timothyhollabaugh/micromouse/non_technical/flow.png

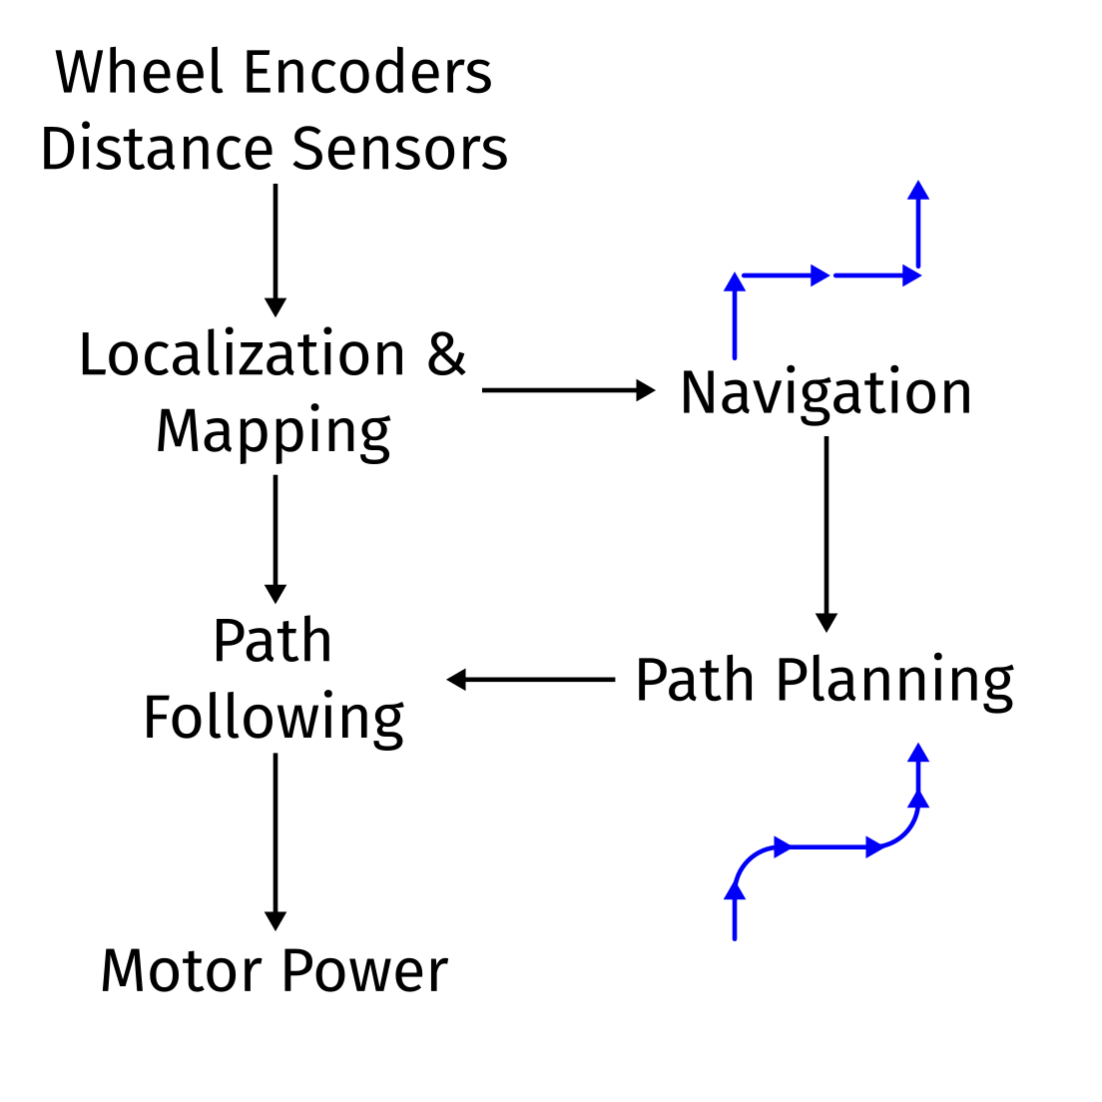
non_technical/flow.png
