timothyhollabaugh/micromouse/electrical/programmer/programmer-F_Cu.dxf

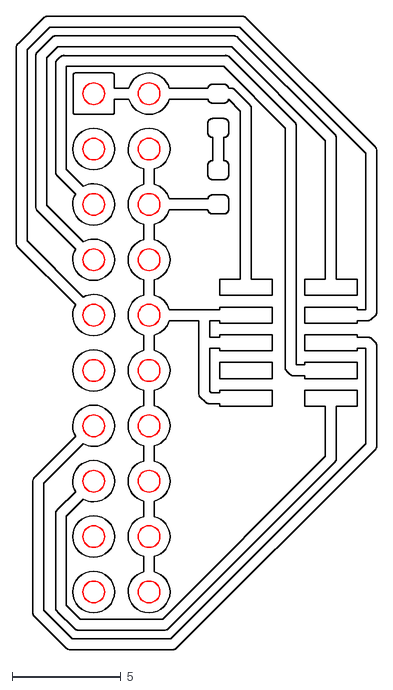
[picture p2: CAD file, 2020-02-29]
electrical/programmer/programmer-F_Cu.dxf
16.5 x 29.1
