timothyhollabaugh/micromouse/non_technical/paths.dxf

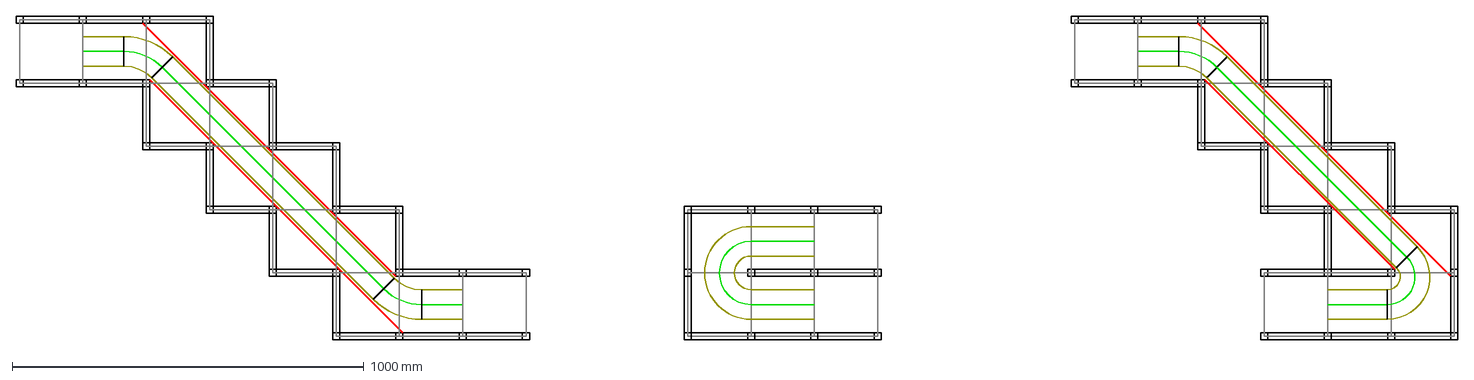
[picture p3: CAD file, 2020-01-07]
non_technical/paths.dxf
4100.0 x 920.0 mm
