timothyhollabaugh/micromouse/electrical/programmer/programmer-Edge_Cuts.dxf

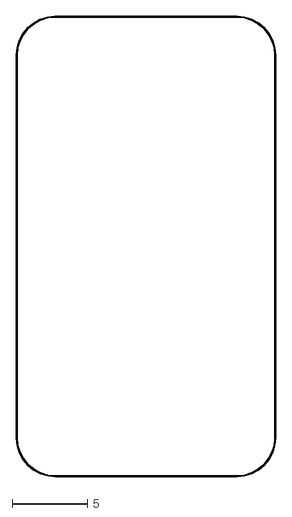
[picture p4: CAD file, 2020-02-29]
electrical/programmer/programmer-Edge_Cuts.dxf
17.2 x 30.5
