timothyhollabaugh/micromouse/electrical/programmer/programmer-B_Cu.dxf

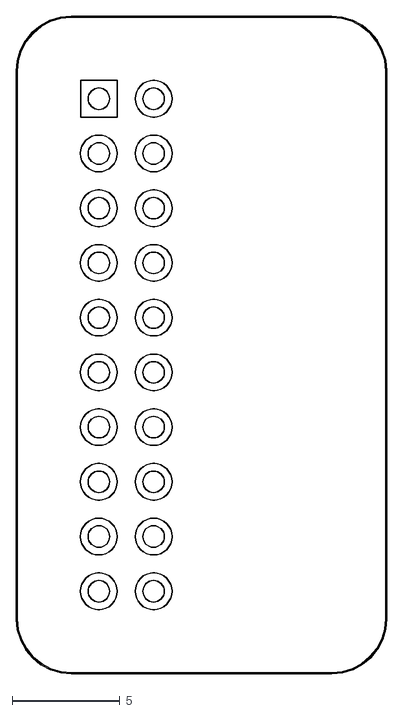
[picture p5: CAD file, 2020-02-29]
electrical/programmer/programmer-B_Cu.dxf
17.2 x 30.5
