timothyhollabaugh/micromouse/electrical/board/board2.kicad_pcb

## KiCad design electrical/board/board2.kicad_pcb (2020-02-29)

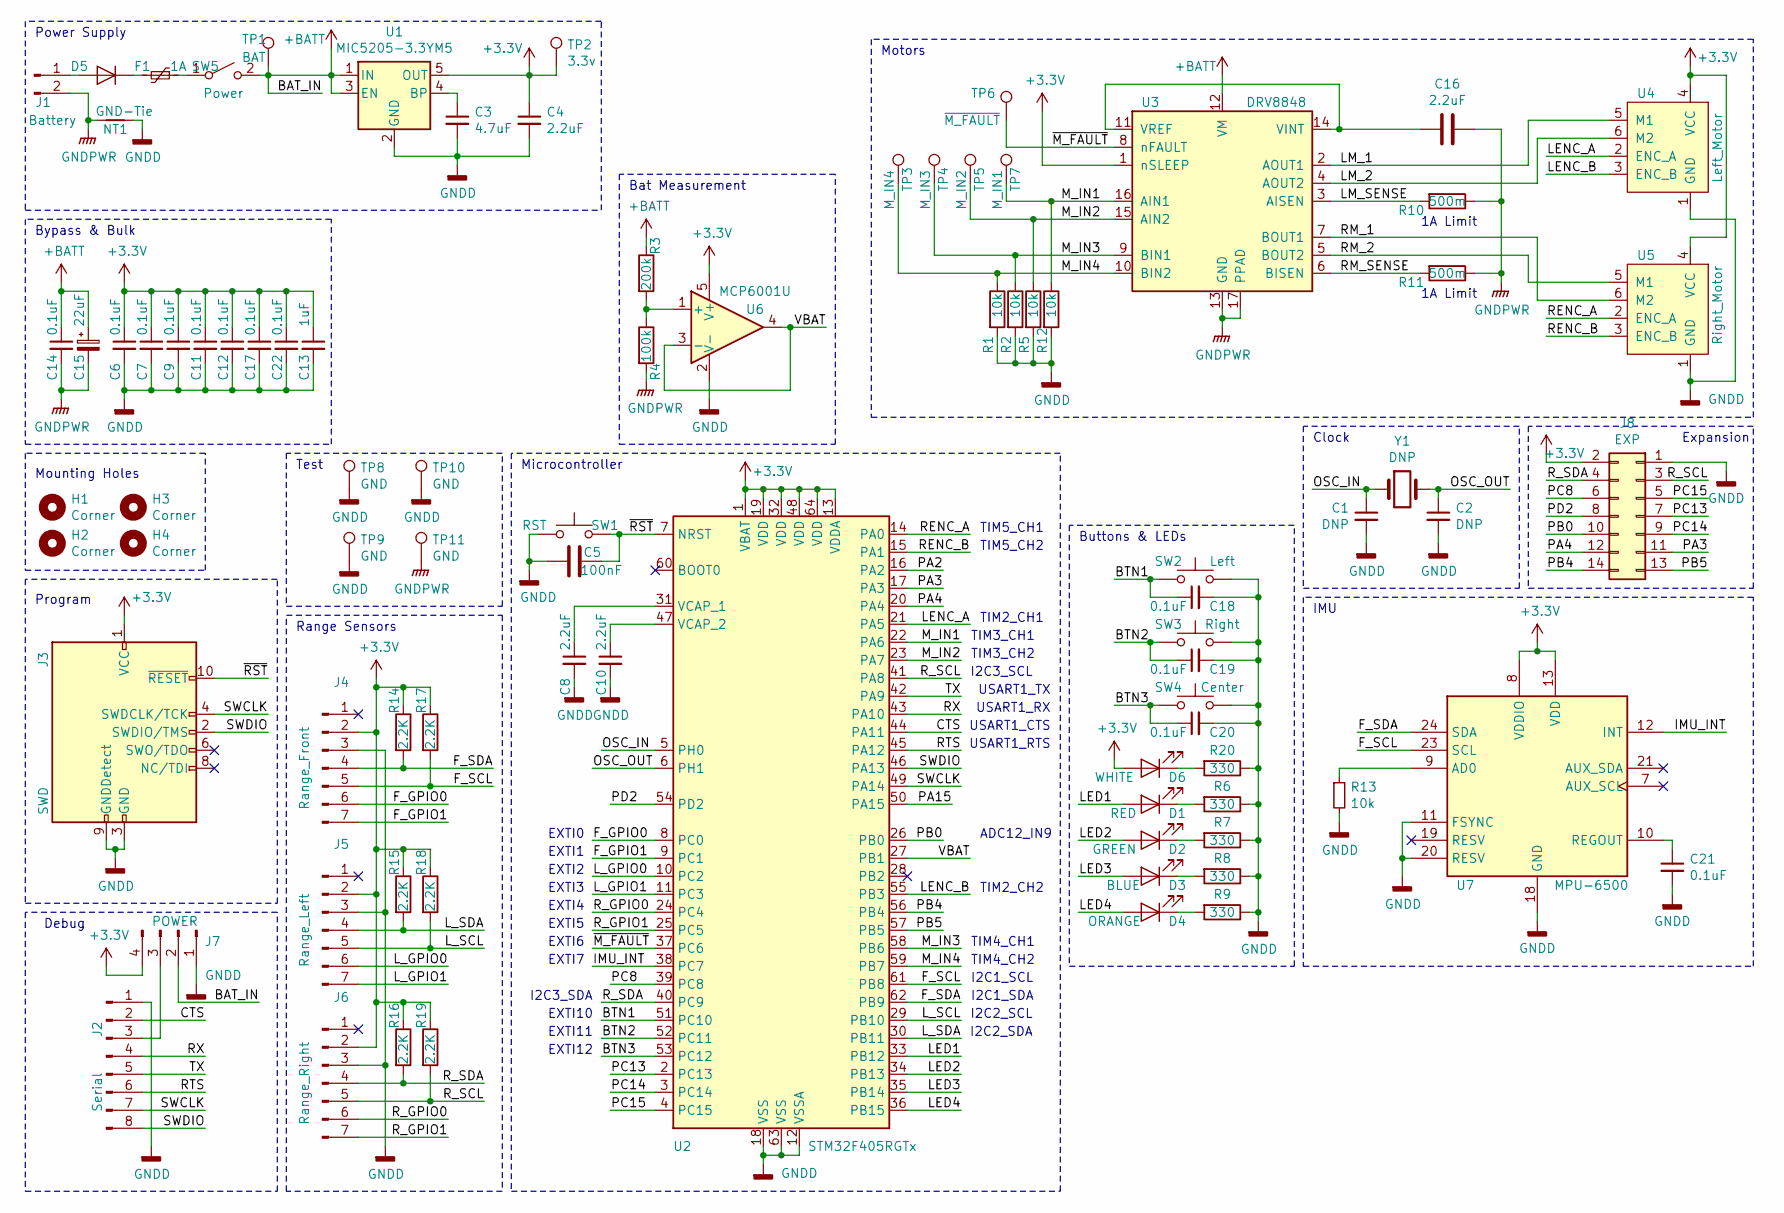
[picture p6: schematic board2.sch, Micromouse]

Parts:
C1, C2: DNP; C_0603_1608Metric
C3: 4.7uF; C_0603_1608Metric
C4, C8, C10, C16: 2.2uF; C_0603_1608Metric
C5: 100nF; C_0603_1608Metric
C6, C7, C9, C11, C12, C14, C17, C18, C19, C20, C21, C22: 0.1uF; C_0603_1608Metric
C13: 1uF; C_0603_1608Metric
C15: 22uF; CP_Elec_4x4.5
D1: RED; LED_0603_1608Metric
D2: GREEN; LED_0603_1608Metric
D3: BLUE; LED_0603_1608Metric
D4: ORANGE; LED_0603_1608Metric
D5: DB2441700L; SC-110A-2
D6: WHITE; LED_0603_1608Metric
F1: 1A; Littlefuse_154
H1, H2, H3, H4: Corner; MountingHole_2.2mm_M2
J1: Battery; PinHeader_1x02_P2.54mm_Horizontal
J2: Serial; PinHeader_1x08_P2.54mm_Vertical_SMD_Pin1Left
J3: SWD; PinHeader_2x05_P1.27mm_Vertical_SMD
J4: Range_Front; PinSocket_1x07_P2.54mm_Vertical
J5: Range_Left; PinSocket_1x07_P2.54mm_Vertical
J6: Range_Right; PinSocket_1x07_P2.54mm_Vertical
J7: POWER; PinHeader_1x04_P2.54mm_Vertical_SMD_Pin1Left
J8: EXP; PinHeader_2x07_P2.00mm_Vertical_SMD
NT1: GND-Tie; NetTie-2_SMD_Pad0.5mm
R1, R2, R5, R12, R13: 10k; R_0603_1608Metric
R3: 200k; R_0603_1608Metric
R4: 100k; R_0603_1608Metric
R6, R7, R8, R9, R20: 330; R_0603_1608Metric
R10, R11: 500m; R_1210_3225Metric
R14, R15, R16, R17, R18, R19: 2.2K; R_0603_1608Metric
SW1: RST; SW_SPST_PTS810
SW2: Left; SW_SPST_PTS810
SW3: Right; SW_SPST_PTS810
SW4: Center; SW_SPST_PTS810
SW5: Power; PinHeader_2x01_P2.54mm_Vertical_SMD
TP1: BAT; TestPoint_Pad_1.8x1.0mm
TP2: 3.3v; TestPoint_Pad_1.8x1.0mm
TP3: M_IN4; TestPoint_Pad_1.8x1.0mm
TP4: M_IN3; TestPoint_Pad_1.8x1.0mm
TP5: M_IN2; TestPoint_Pad_1.8x1.0mm
TP6: ~M_FAULT; TestPoint_Pad_1.8x1.0mm
TP7: M_IN1; TestPoint_Pad_1.8x1.0mm
TP8, TP9, TP10, TP11: GND; TestPoint_Pad_1.8x1.0mm
U1: MIC5205-3.3YM5; SOT-23-5
U2: STM32F405RGTx; LQFP-64_10x10mm_P0.5mm
U3: DRV8848; TSSOP-16_4.4x5mm_P0.65mm
U4: Left_Motor; Molex_PicoBlade_53261-0671_1x06-1MP_P1.25mm_Horizontal
U5: Right_Motor; Molex_PicoBlade_53261-0671_1x06-1MP_P1.25mm_Horizontal
U6: MCP6001U; SOT-23-5
U7: MPU-6500; InvenSense_QFN-24_4x4mm_P0.5mm
Y1: DNP; Crystal_SMD_0603-2Pin_6.0x3.5mm

Connections:
+3V3: C4.1, C6.1, C7.1, C9.1, C11.1, C12.1, C13.1, C17.1, C22.1, D6.2 (A), J3.1 (VCC), J4.2, J5.2, J6.2, J7.4, J8.2, R14.1, R15.1, R16.1, R17.1, R18.1, R19.1, TP2.1, U1.5 (OUT), U2.1 (VBAT), U2.13 (VDDA), U2.19 (VDD), U2.32 (VDD), U2.48 (VDD), U2.64 (VDD), U3.1 (nSLEEP), U4.4 (VCC), U5.4 (VCC), U6.5 (V+), U7.8 (VDDIO), U7.13 (VDD)
+BATT: C14.1, C15.1, J7.2, R3.1, SW5.2 (B), TP1.1, U1.1 (IN), U1.3 (EN), U3.12 (VM)
/BTN1: C18.1, SW2.1, U2.51 (PC10)
/BTN2: C19.1, SW3.1, U2.52 (PC11)
/BTN3: C20.1, SW4.1, U2.53 (PC12)
/CTS: J2.2, U2.44 (PA11)
/F_GPIO0: J4.6, U2.8 (PC0)
/F_GPIO1: J4.7, U2.9 (PC1)
/F_SCL: J4.5, R17.2, U2.61 (PB8), U7.23 (SCL)
/F_SDA: J4.4, R14.2, U2.62 (PB9), U7.24 (SDA)
/IMU_INT: U2.38 (PC7), U7.12 (INT)
/LED1: D1.2 (A), U2.33 (PB12)
/LED2: D2.2 (A), U2.34 (PB13)
/LED3: D3.2 (A), U2.35 (PB14)
/LED4: D4.2 (A), U2.36 (PB15)
/LENC_A: U2.21 (PA5), U4.2 (ENC_A)
/LENC_B: U2.55 (PB3), U4.3 (ENC_B)
/LM_1: U3.2 (AOUT1), U4.5 (M1)
/LM_2: U3.4 (AOUT2), U4.6 (M2)
/LM_SENSE: R10.2, U3.3 (AISEN)
/L_GPIO0: J5.6, U2.10 (PC2)
/L_GPIO1: J5.7, U2.11 (PC3)
/L_SCL: J5.5, R18.2, U2.29 (PB10)
/L_SDA: J5.4, R15.2, U2.30 (PB11)
/M_IN1: R12.1, TP7.1, U2.22 (PA6), U3.16 (AIN1)
/M_IN2: R5.1, TP5.1, U2.23 (PA7), U3.15 (AIN2)
/M_IN3: R2.1, TP4.1, U2.58 (PB6), U3.9 (BIN1)
/M_IN4: R1.1, TP3.1, U2.59 (PB7), U3.10 (BIN2)
/OSC_IN: C1.1, U2.5 (PH0), Y1.1
/OSC_OUT: C2.1, U2.6 (PH1), Y1.2
/PA3: J8.11, U2.17 (PA3)
/PA4: J8.12, U2.20 (PA4)
/PB0: J8.10, U2.26 (PB0)
/PB4: J8.14, U2.56 (PB4)
/PB5: J8.13, U2.57 (PB5)
/PC8: J8.6, U2.39 (PC8)
/PC13: J8.7, U2.2 (PC13)
/PC14: J8.9, U2.3 (PC14)
/PC15: J8.5, U2.4 (PC15)
/PD2: J8.8, U2.54 (PD2)
/RENC_A: U2.14 (PA0), U5.2 (ENC_A)
/RENC_B: U2.15 (PA1), U5.3 (ENC_B)
/RM_1: U3.7 (BOUT1), U5.6 (M2)
/RM_2: U3.5 (BOUT2), U5.5 (M1)
/RM_SENSE: R11.2, U3.6 (BISEN)
/RTS: J2.6, U2.45 (PA12)
/RX: J2.4, U2.43 (PA10)
/R_GPIO0: J6.6, U2.24 (PC4)
/R_GPIO1: J6.7, U2.25 (PC5)
/R_SCL: J6.5, J8.3, R19.2, U2.41 (PA8)
/R_SDA: J6.4, J8.4, R16.2, U2.40 (PC9)
/SWCLK: J2.7, J3.4 (SWDCLK/TCK), U2.49 (PA14)
/SWDIO: J2.8, J3.2 (SWDIO/TMS), U2.46 (PA13)
/TX: J2.5, U2.42 (PA9)
/VBAT: U2.27 (PB1), U6.3 (-), U6.4
/~M_FAULT: TP6.1, U2.37 (PC6), U3.8 (nFAULT)
/~RST: C5.1, J3.10 (~RESET~), SW1.2, U2.7 (NRST)
GNDD: C1.2, C2.2, C3.2, C4.2, C5.2, C6.2, C7.2, C8.2, C9.2, C10.2, C11.2, C12.2, C13.2, C17.2, C18.2, C19.2, C20.2, C21.2, C22.2, J2.1, J3.3 (GND), J3.5 (GND), J3.9 (GNDDetect), J4.3, J5.3, J6.3, J7.1, J8.1, NT1.2, R1.2, R2.2, R5.2, R6.1, R7.1, R8.1, R9.1, R12.2, R13.2, R20.1, SW1.1, SW2.2, SW3.2, SW4.2, TP8.1, TP9.1, TP10.1, U1.2 (GND), U2.12 (VSSA), U2.18 (VSS), U2.63 (VSS), U4.1 (GND), U5.1 (GND), U6.2 (V-), U7.11 (FSYNC), U7.18 (GND), U7.20 (RESV)
GNDPWR: C14.2, C15.2, C16.1, J1.2, NT1.1, R4.2, R10.1, R11.1, TP11.1, U3.13 (GND), U3.17 (PPAD)
unnamed: C3.1, U1.4 (BP)
unnamed: C8.1, U2.31 (VCAP_1)
unnamed: C10.1, U2.47 (VCAP_2)
unnamed: C16.2, U3.11 (VREF), U3.14 (VINT)
unnamed: C21.1, U7.10 (REGOUT)
unnamed: D1.1 (K), R6.2
unnamed: D2.1 (K), R7.2
unnamed: D3.1 (K), R8.2
unnamed: D4.1 (K), R9.2
unnamed: D5.1 (K), F1.2
unnamed: D5.2 (A), J1.1
unnamed: D6.1 (K), R20.2
unnamed: F1.1, SW5.1 (A)
unnamed: J2.3, J7.3
unnamed: R3.2, R4.1, U6.1 (+)
unnamed: R13.1, U7.9 (AD0)

Notes on the sheet:
TIM3_CH1
TIM3_CH2
TIM4_CH1
TIM4_CH2
TIM5_CH1
TIM5_CH2
TIM2_CH1
TIM2_CH2
I2C1_SCL
I2C1_SDA
I2C2_SCL
I2C2_SDA
I2C3_SCL
I2C3_SDA
EXTI0
EXTI1
EXTI2
EXTI3
EXTI4
EXTI5
EXTI6
USART1_TX
USART1_RX
USART1_CTS
USART1_RTS
EXTI10
EXTI11
EXTI12
ADC12_IN9
EXTI7
Range Sensors
IMU
Microcontroller
Buttons & LEDs
Expansion
Clock
Program
Debug
Test
Power Supply
Bypass & Bulk
Bat Measurement
Motors
1A Limit
Mounting Holes

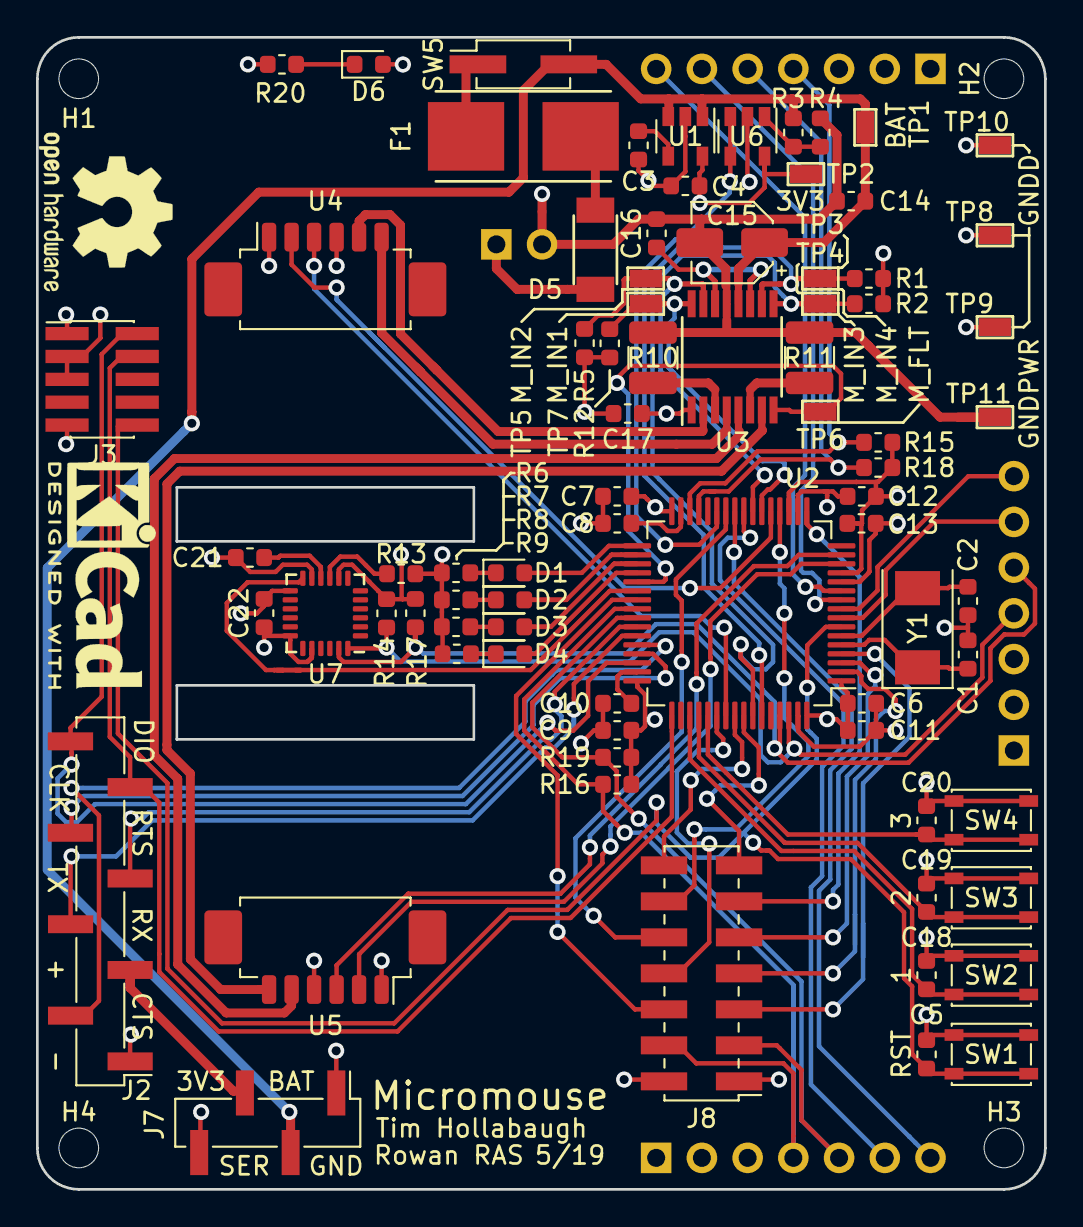
[picture p7: board board2.kicad_pcb from above]

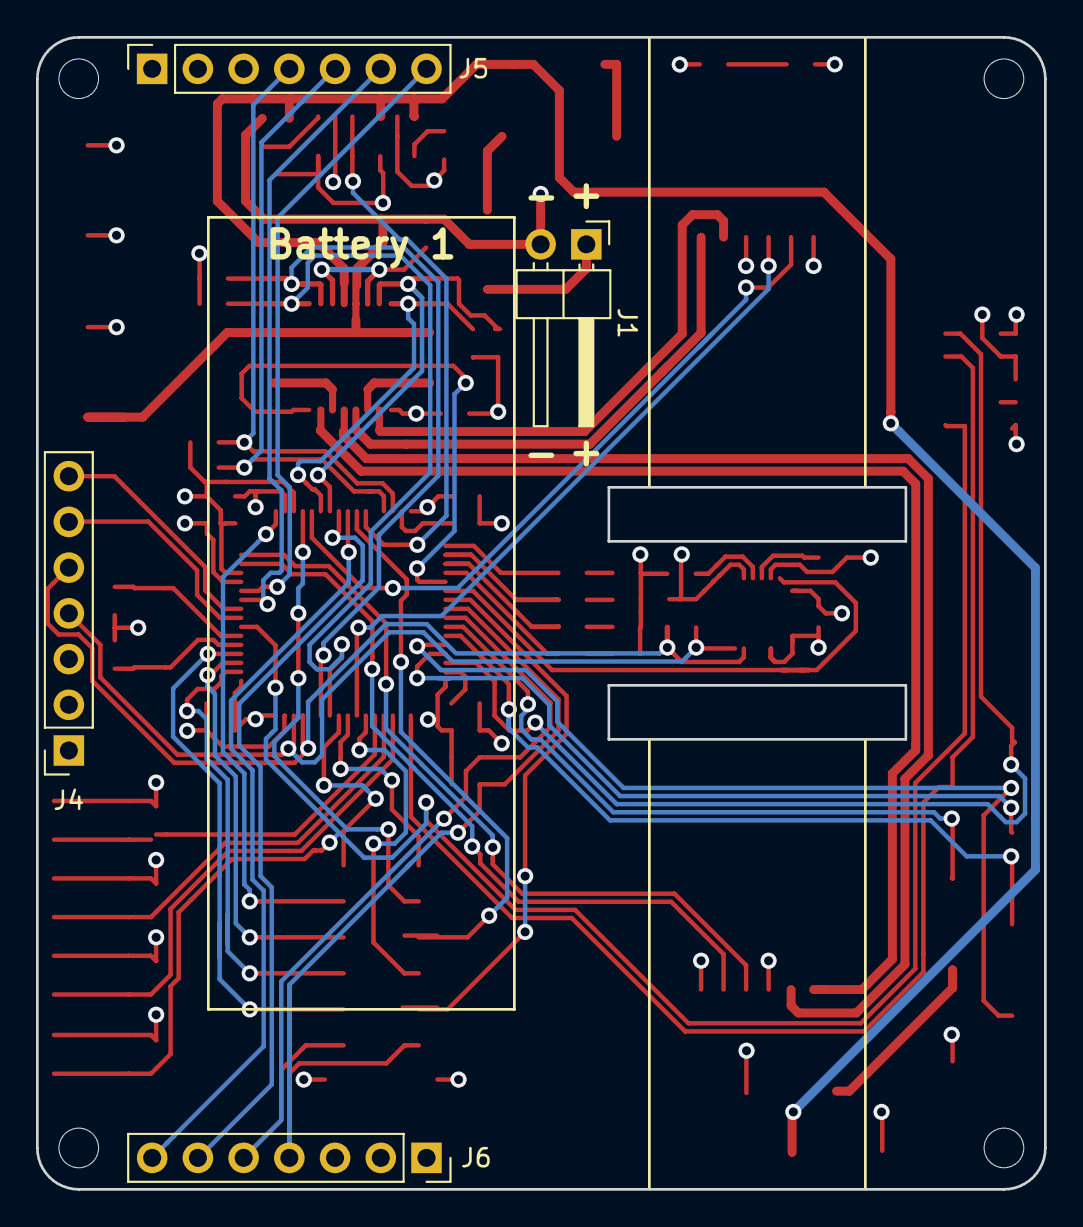
[picture p8: board board2.kicad_pcb from below]

Board: 4 copper layers, 56.0 x 64.0 mm, 86 parts (4 on the bottom side), 75 nets.
