timothyhollabaugh/micromouse/electrical/programmer/programmer.kicad_pcb

## KiCad design electrical/programmer/programmer.kicad_pcb (2020-02-29)

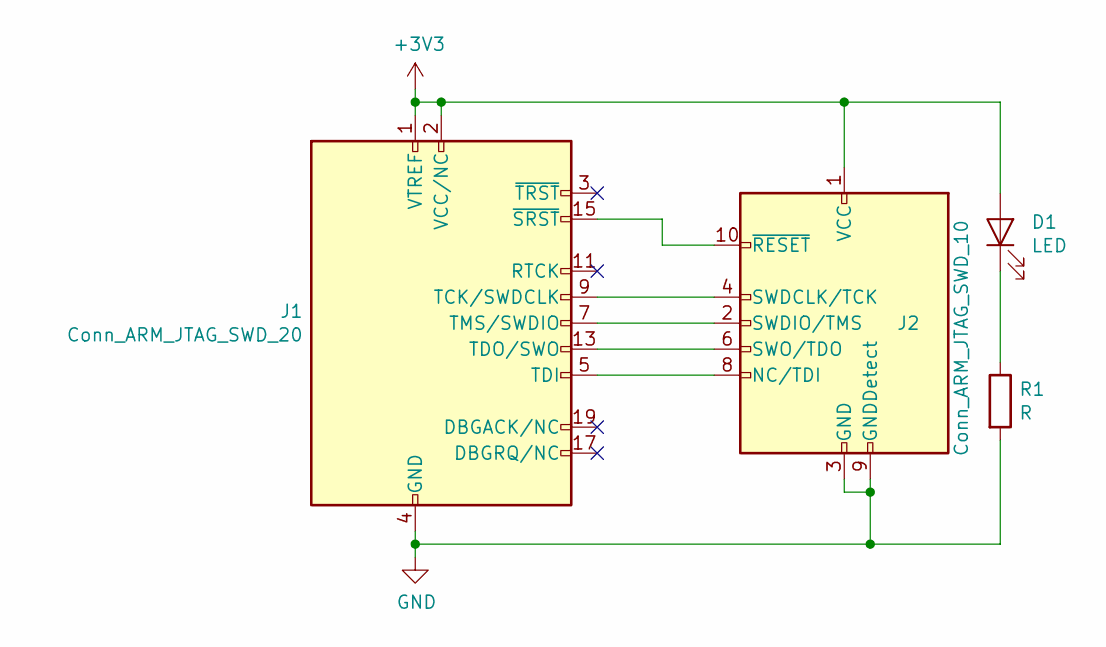
[picture p9: schematic programmer.sch]

Parts:
D1: LED; LED_0603_1608Metric
J1: Conn_ARM_JTAG_SWD_20; PinHeader_2x10_P2.54mm_Vertical
J2: Conn_ARM_JTAG_SWD_10; PinHeader_2x05_P1.27mm_Vertical_SMD
R1: R; R_0603_1608Metric

Connections:
+3V3: D1.2 (A), J1.1 (VTREF), J1.2 (VCC/NC), J2.1 (VCC)
GND: J1.4 (GND), J1.6 (GND), J1.8 (GND), J1.10 (GND), J1.12 (GND), J1.14 (GND), J1.16 (GND), J1.18 (GND), J1.20 (GND), J2.3 (GND), J2.5 (GND), J2.9 (GNDDetect), R1.2
unnamed: D1.1 (K), R1.1
unnamed: J1.5 (TDI), J2.8 (NC/TDI)
unnamed: J1.7 (TMS/SWDIO), J2.2 (SWDIO/TMS)
unnamed: J1.9 (TCK/SWDCLK), J2.4 (SWDCLK/TCK)
unnamed: J1.13 (TDO/SWO), J2.6 (SWO/TDO)
unnamed: J1.15 (~SRST~), J2.10 (~RESET~)

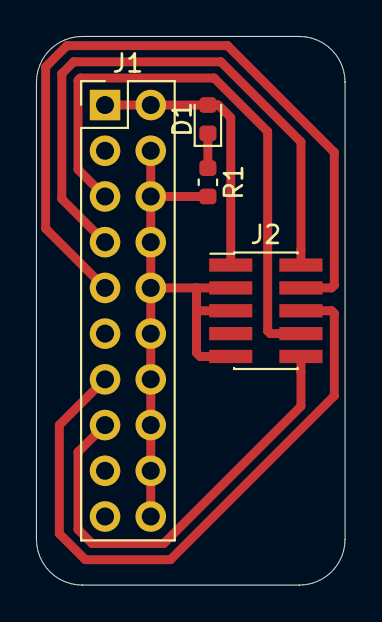
[picture p10: board programmer.kicad_pcb from above]

Board: 2 copper layers, 17.1 x 30.5 mm, 4 parts (0 on the bottom side), 8 nets.
