timothyhollabaugh/micromouse/software/micromouse_logic/src/mouse.rs

use core::f32;

use serde::{Deserialize, Serialize};

use crate::config::MechanicalConfig;

use crate::fast::localize::{Localize, LocalizeConfig, LocalizeDebug};
use crate::fast::motion_queue::{Motion, MotionQueue, MotionQueueDebug};
use crate::fast::{Direction, Orientation, Vector};

use crate::fast::motion_control::{
    MotionControl, MotionControlConfig, MotionControlDebug,
};
use crate::fast::path::PathMotion;
use crate::slow::map::{Map, MapConfig};
use crate::slow::maze::{Maze, MazeConfig};
use crate::slow::motion_plan::{motion_plan, MotionPlanConfig};
use crate::slow::navigate::TwelvePartitionNavigate;
use crate::slow::{MazeDirection, MazeOrientation, SlowDebug};
use core::cmp::Ordering;

#[derive(Debug, Clone, Default, PartialEq, Serialize, Deserialize)]
pub struct HardwareDebug {
    pub left_encoder: i32,
    pub right_encoder: i32,
    pub left_distance: Option<DistanceReading>,
    pub front_distance: Option<DistanceReading>,
    pub right_distance: Option<DistanceReading>,
}

#[derive(Debug, Clone, Default, PartialEq, Serialize, Deserialize)]
pub struct MouseDebug {
    pub hardware: HardwareDebug,
    pub orientation: Orientation,
    pub maze_orientation: MazeOrientation,
    pub localize: LocalizeDebug,
    pub motion_control: MotionControlDebug,
    pub motion_queue: MotionQueueDebug,
    pub slow: Option<SlowDebug>,
    pub battery: u16,
    pub time: u32,
    pub delta_time: u32,
}

#[derive(Debug, Copy, Clone, Default, PartialEq, Serialize, Deserialize)]
pub struct MouseConfig {
    pub mechanical: MechanicalConfig,
    pub localize: LocalizeConfig,
    pub map: MapConfig,
    pub motion_plan: MotionPlanConfig,
    pub maze: MazeConfig,
    pub motion_control: MotionControlConfig,
    pub front_sensor_abort: f32,
    pub left_sensor_abort: f32,
    pub right_sensor_abort: f32,
}

pub trait ContainsDistanceReading {
    fn value(self) -> Option<f32>;
}

#[derive(Debug, Copy, Clone, PartialEq, Serialize, Deserialize)]
pub enum DistanceReading {
    /// There is a reading that is within range and valid
    InRange(f32),

    /// There is a reading, but it is out of range
    OutOfRange,
}

impl PartialEq<f32> for DistanceReading {
    fn eq(&self, other: &f32) -> bool {
        match self {
            DistanceReading::InRange(value) => value == other,
            DistanceReading::OutOfRange => false,
        }
    }
}

impl PartialEq<DistanceReading> for f32 {
    fn eq(&self, other: &DistanceReading) -> bool {
        match other {
            DistanceReading::InRange(value) => value == other,
            DistanceReading::OutOfRange => false,
        }
    }
}

impl PartialOrd<f32> for DistanceReading {
    fn partial_cmp(&self, other: &f32) -> Option<Ordering> {
        match self {
            DistanceReading::InRange(value) => value.partial_cmp(other),
            DistanceReading::OutOfRange => Some(Ordering::Greater),
        }
    }
}

impl PartialOrd<DistanceReading> for f32 {
    fn partial_cmp(&self, other: &DistanceReading) -> Option<Ordering> {
        match other {
            DistanceReading::InRange(value) => other.partial_cmp(value),
            DistanceReading::OutOfRange => Some(Ordering::Less),
        }
    }
}

impl ContainsDistanceReading for Option<DistanceReading> {
    /// Returns Some(value) if the distance reading is Some(InRange),
    /// None otherwise
    fn value(self) -> Option<f32> {
        if let Some(DistanceReading::InRange(value)) = self {
            Some(value)
        } else {
            None
        }
    }
}

pub struct Mouse {
    last_time: u32,
    map: Map,
    navigate: TwelvePartitionNavigate,
    localize: Localize,
    motion_queue: MotionQueue,
    motion_control: MotionControl,
    moves_completed: usize,
}

impl Mouse {
    pub fn new(
        config: &MouseConfig,
        orientation: Orientation,
        time: u32,
        left_encoder: i32,
        right_encoder: i32,
    ) -> Mouse {
        Mouse {
            last_time: time,
            map: Map::new(),
            navigate: TwelvePartitionNavigate::new(),
            localize: Localize::new(orientation, left_encoder, right_encoder),
            motion_control: MotionControl::new(
                &config.motion_control,
                time,
                left_encoder,
                right_encoder,
                orientation,
            ),
            motion_queue: MotionQueue::new(),
            moves_completed: 0,
        }
    }

    pub fn update(
        &mut self,
        config: &MouseConfig,
        time: u32,
        battery: u16,
        left_encoder: i32,
        right_encoder: i32,
        left_distance: Option<DistanceReading>,
        front_distance: Option<DistanceReading>,
        right_distance: Option<DistanceReading>,
    ) -> (i32, i32, MouseDebug) {
        let delta_time = time - self.last_time;

        let (orientation, localize_debug) = self.localize.update(
            &config.mechanical,
            &config.maze,
            &config.localize,
            left_encoder,
            right_encoder,
            left_distance,
            front_distance,
            right_distance,
            self.motion_queue.next_motion(),
            self.moves_completed,
        );

        let (motion_going_forward, motion_going_left, motion_going_right) =
            match self.motion_queue.next_motion() {
                Some(Motion::Path(path_motion)) => {
                    let front_abort = config.mechanical.front_sensor_offset_x
                        + config.front_sensor_abort;
                    let left_abort =
                        config.mechanical.left_sensor_offset_y + config.left_sensor_abort;
                    let right_abort = config.mechanical.right_sensor_offset_y
                        + config.right_sensor_abort;

                    match orientation.to_maze_orientation(&config.maze).direction {
                        MazeDirection::North => (
                            path_motion.end().y > orientation.position.y + front_abort,
                            path_motion.end().x < orientation.position.x - left_abort,
                            path_motion.end().x > orientation.position.x + right_abort,
                        ),
                        MazeDirection::South => (
                            path_motion.end().y < orientation.position.y - front_abort,
                            path_motion.end().x > orientation.position.x + left_abort,
                            path_motion.end().x < orientation.position.x - right_abort,
                        ),
                        MazeDirection::East => (
                            path_motion.end().x > orientation.position.x + front_abort,
                            path_motion.end().y > orientation.position.y - left_abort,
                            path_motion.end().y < orientation.position.y + right_abort,
                        ),
                        MazeDirection::West => (
                            path_motion.end().x < orientation.position.x - front_abort,
                            path_motion.end().y < orientation.position.y + left_abort,
                            path_motion.end().y > orientation.position.y - right_abort,
                        ),
                    }
                }

                _ => (false, false, false),
            };

        let abort_front = front_distance
            .value()
            .map(|d| motion_going_forward && d < config.front_sensor_abort)
            .unwrap_or(false);

        let abort_left = left_distance
            .value()
            .map(|d| motion_going_left && d < config.left_sensor_abort)
            .unwrap_or(false);

        let abort_right = right_distance
            .value()
            .map(|d| motion_going_right && d < config.right_sensor_abort)
            .unwrap_or(false);

        let abort_moves = abort_front || abort_left || abort_right;

        self.moves_completed = if abort_moves {
            let len = self.motion_queue.motions_remaining();
            self.motion_queue.clear();
            len
        } else {
            self.motion_queue
                .pop_completed(&config.motion_control.turn, orientation)
        };

        let slow_debug = if self.motion_queue.motions_remaining() == 0 {
            let (move_options, map_debug) = self.map.update(
                &config.mechanical,
                &config.maze,
                &config.map,
                orientation.to_maze_orientation(&config.maze),
                left_distance,
                front_distance,
                right_distance,
            );

            if let Some(move_options) = move_options {
                let (next_direction, navigate_debug) = self.navigate.navigate(
                    orientation.to_maze_orientation(&config.maze),
                    move_options,
                );

                let path = motion_plan(
                    &config.motion_plan,
                    &config.maze,
                    orientation,
                    &[next_direction],
                );

                self.motion_queue.add_motions(&path).ok();

                // TODO: Get the move options and map debug out even if they are None
                Some(SlowDebug {
                    map: map_debug,
                    move_options,
                    navigate: navigate_debug,
                    next_direction,
                })
            } else {
                None
            }
        } else {
            None
        };

        let (left_power, right_power, motion_debug) = self.motion_control.update(
            &config.motion_control,
            &config.mechanical,
            time,
            left_encoder,
            right_encoder,
            self.motion_queue.next_motion(),
            orientation,
        );

        let hardware_debug = HardwareDebug {
            left_encoder,
            right_encoder,
            left_distance,
            front_distance,
            right_distance,
        };

        let debug = MouseDebug {
            hardware: hardware_debug,
            orientation,
            maze_orientation: orientation.to_maze_orientation(&config.maze),
            localize: localize_debug,
            motion_control: motion_debug,
            motion_queue: self.motion_queue.debug(),
            slow: slow_debug,
            battery,
            time,
            delta_time,
        };

        self.last_time = time;

        (left_power, right_power, debug)
    }
}

pub struct TestMouse {}

impl TestMouse {
    pub fn new() -> TestMouse {
        TestMouse {}
    }

    pub fn update(
        &mut self,
        _config: &MouseConfig,
        time: u32,
        _left_encoder: i32,
        _right_encoder: i32,
    ) -> (f32, f32) {
        if time % 10000 <= 5000 {
            (0.0, 0.0)
        } else {
            (1.0, 1.0)
        }
    }
}
