timothyhollabaugh/micromouse/software/micromouse_firmware/src/motors/left.rs

use core::i32;

use stm32f4xx_hal::stm32 as stm32f405;

use crate::motors::{Encoder, Motor};

const FORWARD_DEADBAND: i32 = 0;
const BACKWARD_DEADBAND: i32 = 0;

pub struct LeftMotor {
    timer: stm32f405::TIM3,
}

impl LeftMotor {
    pub fn setup(
        rcc: &stm32f405::RCC,
        timer: stm32f405::TIM3,
        gpio: &stm32f405::GPIOA,
    ) -> LeftMotor {
        // Enable clock for gpio a
        rcc.ahb1enr.modify(|_, w| w.gpioaen().set_bit());

        // Enable clock for timer 3
        rcc.apb1enr.modify(|_, w| w.tim3en().set_bit());

        // Set pins to alternate function
        gpio.moder
            .modify(|_, w| w.moder6().alternate().moder7().alternate());

        // Set the alternate function to timer 3 channel 1 and 2
        gpio.afrl.modify(|_, w| w.afrl6().af2().afrl7().af2());

        // setup the timer
        timer.psc.write(|w| w.psc().bits(10u16));
        timer.cr1.write(|w| w.arpe().set_bit());
        timer.arr.write(|w| w.arr().bits(10000u16));
        timer.ccr1.write(|w| w.ccr().bits(0u16));
        timer.ccr2.write(|w| w.ccr().bits(0u16));
        timer.ccmr1_output().write(|w| {
            w.oc1m()
                .bits(0b110)
                .oc1pe()
                .set_bit()
                .oc2m()
                .bits(0b110)
                .oc2pe()
                .set_bit()
        });
        //timer.egr.write(|w| w.ug().set_bit());
        timer.ccer.write(|w| w.cc1e().clear_bit().cc2e().set_bit());
        timer.cr1.modify(|_, w| w.cen().set_bit());

        LeftMotor { timer }
    }
}

impl Motor for LeftMotor {
    fn change_power(&mut self, power: i32) {
        self.timer.ccer.write(|w| {
            if power > 0 {
                let speed = (power.abs() + FORWARD_DEADBAND) as u16;
                self.timer.ccr1.write(|w| w.ccr().bits(speed));
                self.timer.ccr2.write(|w| w.ccr().bits(speed));
                w.cc1e().clear_bit().cc2e().set_bit()
            } else if power < 0 {
                let speed = (power.abs() + BACKWARD_DEADBAND) as u16;
                self.timer.ccr1.write(|w| w.ccr().bits(speed));
                self.timer.ccr2.write(|w| w.ccr().bits(speed));
                w.cc1e().set_bit().cc2e().clear_bit()
            } else {
                let speed = 0;
                self.timer.ccr1.write(|w| w.ccr().bits(speed));
                self.timer.ccr2.write(|w| w.ccr().bits(speed));
                w.cc1e().set_bit().cc2e().clear_bit()
            }
        });
    }
}

pub struct LeftEncoder {
    timer: stm32f405::TIM2,
}

impl LeftEncoder {
    pub fn setup(
        rcc: &stm32f405::RCC,
        gpioa: &stm32f405::GPIOA,
        gpiob: &stm32f405::GPIOB,
        timer: stm32f405::TIM2,
    ) -> LeftEncoder {
        rcc.ahb1enr
            .modify(|_, w| w.gpioaen().set_bit().gpioben().set_bit());
        rcc.apb1enr.modify(|_, w| w.tim2en().set_bit());

        gpioa.moder.modify(|_, w| w.moder5().alternate());
        gpiob.moder.modify(|_, w| w.moder3().alternate());

        gpioa.afrl.modify(|_, w| w.afrl5().af1());
        gpiob.afrl.modify(|_, w| w.afrl3().af1());

        timer
            .ccmr1_output()
            .write(|w| unsafe { w.cc1s().bits(0b01).cc2s().bits(0b01) });
        timer.smcr.write(|w| w.sms().bits(0b011));
        timer.ccer.write(|w| w.cc1e().set_bit().cc2e().set_bit());
        timer.cr1.write(|w| w.cen().set_bit());

        LeftEncoder { timer }
    }
}

impl Encoder for LeftEncoder {
    fn count(&self) -> i32 {
        self.timer.cnt.read().cnt().bits() as i32
    }

    fn reset(&mut self) {
        self.timer.cnt.write(|w| w.cnt().bits(0));
    }
}
