timothyhollabaugh/micromouse/software/micromouse_logic/src/fast/turn.rs

use serde::{Deserialize, Serialize};

use pid_control::{Controller, PIDController};

use super::Direction;
use crate::config::MechanicalConfig;
use crate::fast::{Orientation, DIRECTION_PI_2};

#[derive(Debug, Copy, Clone, PartialEq, Serialize, Deserialize)]
pub enum TurnDirection {
    Clockwise,
    Counterclockwise,
}

#[derive(Debug, Copy, Clone, PartialEq, Serialize, Deserialize)]
pub struct TurnMotion {
    target: Direction,
    direction: TurnDirection,
}

impl TurnMotion {
    pub fn new(current: Direction, target: Direction) -> TurnMotion {
        let direction = if target - current < DIRECTION_PI_2 {
            TurnDirection::Counterclockwise
        } else {
            TurnDirection::Clockwise
        };

        TurnMotion { target, direction }
    }

    pub fn done(&self, config: &TurnHandlerConfig, orientation: Orientation) -> bool {
        orientation.direction.within(self.target, config.tolerance)
    }
}

#[derive(Debug, Copy, Clone, Default, PartialEq, Serialize, Deserialize)]
pub struct TurnHandlerConfig {
    pub rad_per_sec: f32,
    pub p: f32,
    pub i: f32,
    pub d: f32,
    pub tolerance: f32,
}

#[derive(Debug, Copy, Clone, Default, PartialEq, Serialize, Deserialize)]
pub struct TurnHandlerDebug {
    turn_velocity: f32,
}

pub struct TurnHandler {
    pid: PIDController,
    time: u32,
}

impl TurnHandler {
    pub fn new(config: &TurnHandlerConfig, time: u32) -> TurnHandler {
        let mut pid =
            PIDController::new(config.p as f64, config.i as f64, config.d as f64);
        pid.set_limits(-config.rad_per_sec as f64, config.rad_per_sec as f64);
        TurnHandler { pid, time }
    }

    pub fn update(
        &mut self,
        config: &TurnHandlerConfig,
        mech: &MechanicalConfig,
        time: u32,
        orientation: Orientation,
        motion: TurnMotion,
    ) -> (f32, f32, TurnHandlerDebug) {
        let delta_time = time - self.time;

        self.pid.p_gain = config.p as f64;
        self.pid.i_gain = config.i as f64;
        self.pid.d_gain = config.d as f64;
        self.pid.set_limits(-0.005 as f64, 0.005 as f64);

        let centered_direction = orientation.direction.centered_at(motion.target);

        self.pid.set_target(f32::from(motion.target) as f64);

        let turn_velocity = self
            .pid
            .update(f32::from(centered_direction) as f64, delta_time as f64)
            as f32;

        let left_target = -mech.rads_to_mm(turn_velocity);
        let right_target = mech.rads_to_mm(turn_velocity);

        self.time = time;

        (
            left_target,
            right_target,
            TurnHandlerDebug { turn_velocity },
        )
    }
}
