timothyhollabaugh/micromouse/software/micromouse_firmware/src/system_test.rs

use core::fmt::Write;
use core::str;

use embedded_hal::blocking::i2c;
use embedded_hal::digital::v2::{InputPin, OutputPin, ToggleableOutputPin};

use crate::battery::Battery;
use crate::motors::left::{LeftEncoder, LeftMotor};
use crate::motors::right::{RightEncoder, RightMotor};
use crate::motors::{Encoder, Motor};
use crate::time::Time;
use crate::uart::Uart;
use crate::vl6180x::VL6180x;

struct MotorCommand<M: Motor, E: Encoder> {
    pub motor: M,
    pub encoder: E,
    pub reporting: bool,
}

impl<M: Motor, E: Encoder> MotorCommand<M, E> {
    pub fn parse<'a, I: Iterator<Item = &'a str>>(
        &mut self,
        uart: &mut Uart,
        mut words: I,
    ) {
        match words.next() {
            Some("report") => match words.next() {
                Some("on") => self.reporting = true,
                Some("off") => self.reporting = false,
                word => {
                    writeln!(uart, "Unknown command: {:?}", word).ok();
                }
            },
            Some("set") => {
                if let Some(power) = words.next().and_then(|word| word.parse().ok()) {
                    self.motor.change_power(power);
                } else {
                    writeln!(uart, "Expected a number").ok();
                }
            }
            word => {
                writeln!(uart, "Unknown command: {:?}", word).ok();
            }
        }
    }

    pub fn report(&self, uart: &mut Uart, name: &str) {
        if self.reporting {
            write!(uart, "{}:{},", name, self.encoder.count()).ok();
        }
    }
}

/// Allows testing of the mouse hardware over UART
pub fn do_system_test<RL, GL, BL, OL, LB, RB, I2C1, I2C2, I2C3>(
    mut time: Time,
    battery: Battery,
    _red_led: RL,
    _green_led: GL,
    _blue_led: BL,
    _orange_led: OL,
    _left_button: LB,
    _right_button: RB,
    left_motor: LeftMotor,
    right_motor: RightMotor,
    left_encoder: LeftEncoder,
    right_encoder: RightEncoder,
    mut front_distance: VL6180x<I2C1>,
    mut left_distance: VL6180x<I2C2>,
    mut right_distance: VL6180x<I2C3>,
    mut uart: Uart,
) -> !
where
    RL: OutputPin + ToggleableOutputPin,
    GL: OutputPin + ToggleableOutputPin,
    BL: OutputPin + ToggleableOutputPin,
    OL: OutputPin + ToggleableOutputPin,
    LB: InputPin,
    RB: InputPin,
    I2C1: i2c::Read + i2c::Write + i2c::WriteRead,
    I2C2: i2c::Read + i2c::Write + i2c::WriteRead,
    I2C3: i2c::Read + i2c::Write + i2c::WriteRead,
{
    let mut time_report = false;

    let mut left_motor_command = MotorCommand {
        motor: left_motor,
        encoder: left_encoder,
        reporting: false,
    };

    let mut right_motor_command = MotorCommand {
        motor: right_motor,
        encoder: right_encoder,
        reporting: false,
    };

    let mut left_distance_report = false;
    let mut right_distance_report = false;
    let mut front_distance_report = false;

    let mut last_time = 0;

    loop {
        if let Some(buf) = uart.read_line().ok() {
            if let Some(line) = str::from_utf8(&buf).ok() {
                let mut words = line.trim().split_whitespace();

                match words.next() {
                    Some("time") => match words.next() {
                        Some("report") => match words.next() {
                            Some("on") => time_report = true,
                            Some("off") => time_report = false,
                            word => {
                                writeln!(uart, "Unknown command: {:?}", word).ok();
                            }
                        },
                        word => {
                            writeln!(uart, "Unknown command: {:?}", word).ok();
                        }
                    },
                    Some("motor") => match words.next() {
                        Some("left") => left_motor_command.parse(&mut uart, words),
                        Some("right") => right_motor_command.parse(&mut uart, words),
                        word => {
                            writeln!(uart, "Unknown command: {:?}", word).ok();
                        }
                    },
                    Some("distance") => match words.next() {
                        Some("left") => match words.next() {
                            Some("report") => match words.next() {
                                Some("on") => left_distance_report = true,
                                Some("off") => left_distance_report = false,
                                word => {
                                    writeln!(uart, "Unknown command: {:?}", word).ok();
                                }
                            },
                            word => {
                                writeln!(uart, "Unknown command: {:?}", word).ok();
                            }
                        },
                        Some("right") => match words.next() {
                            Some("report") => match words.next() {
                                Some("on") => right_distance_report = true,
                                Some("off") => right_distance_report = false,
                                word => {
                                    writeln!(uart, "Unknown command: {:?}", word).ok();
                                }
                            },
                            word => {
                                writeln!(uart, "Unknown command: {:?}", word).ok();
                            }
                        },
                        Some("front") => match words.next() {
                            Some("report") => match words.next() {
                                Some("on") => front_distance_report = true,
                                Some("off") => front_distance_report = false,
                                word => {
                                    writeln!(uart, "Unknown command: {:?}", word).ok();
                                }
                            },
                            word => {
                                writeln!(uart, "Unknown command: {:?}", word).ok();
                            }
                        },
                        word => {
                            writeln!(uart, "Unknown command: {:?}", word).ok();
                        }
                    },
                    word => {
                        writeln!(uart, "Unknown command: {:?}", word).ok();
                    }
                }
            }
        }

        if time.now() - last_time >= 1 {
            if time_report {
                write!(uart, "T:{},", time.now()).ok();
            }

            left_motor_command.report(&mut uart, "LM");
            right_motor_command.report(&mut uart, "RM");

            if left_distance_report {
                left_distance.update();
                write!(uart, "LD: {:?}", left_distance.range()).ok();
            }

            if right_distance_report {
                right_distance.update();
                write!(uart, "RD: {:?}", right_distance.range()).ok();
            }

            if front_distance_report {
                front_distance.update();
                write!(uart, "FD: {:?}", front_distance.range()).ok();
            }

            if time_report
                || left_motor_command.reporting
                || right_motor_command.reporting
                || left_distance_report
                || right_distance_report
                || front_distance_report
            {
                uart.add_str("\n").ok();
            }

            last_time = time.now();
        }
    }
}
