timothyhollabaugh/micromouse/(commit log)

2019-10-05 Add mapping module to keep track of location
2019-10-05 Save old encoders and time
2019-10-05 Take current segment from end of buffer, tune some PIDs
    High D and low P
2019-10-06 Got in circles, tune PID
2019-10-06 Factor encoder orientation update out, fix floating point errors
    [main.rs, map.rs, simulation.rs]
2019-10-07 Put simulation in charge of timing
2019-10-13 Switch angles so positive is CCW
2019-10-22 Calculate target direction to get back to center, then do pid on that
    Also add Direction type to handle wrapping at 2pi
2019-10-26 Extra LED debugging
2019-10-27 Print debug with constant formating
2019-11-08 Calc target angle, then PID on that angle instead of PID on the distance
    Helps make sure it is facing the right direction when close to the path
    [board2.sch]
2019-11-13 Add config for 2020 mouse with old wheels
2019-11-13 Change test rectangle to have larger radius
    Avoid large accelerations when turning
    If radius = width/2, there is a segment of 0 length and gets a NaN
    [mouse.rs]
2019-11-16 Start on figuring out what walls we are looking at
    Project the current location to find the nearest wall
2019-11-22 Print performance numbers
    Renders slow on Windows
2019-11-23 Split simulation into gui and simulation threads
    Helps performance a lot on Windows
2019-11-28 Simulate wheel slippage when a wheel accelerates too much
    [main.rs, simulation.rs]
2019-11-29 Attempt to limit power changes to wheels to avoid slipping
    [config.rs, lib.rs, main.rs, motion.rs, mouse.rs, simulation.rs]
2019-12-20 Switch to duid ui. Maze is mostly shown.
2019-12-23 Reset button
2019-12-24 Move start and reset buttons to left
2019-12-25 Graph shows current index and zero
2020-01-01 Connects to mouse, but doesn't send to wasm right
    [lib.rs]
2020-01-03 Clamp history input
2020-01-03 Simpler delta power limiting that limits power per wheel
2020-01-05 Clamp wheel power in simulation
2020-01-05 Redo motion handling.
    Now controlled by linear power and ratio of angular power / linear power. This keeps it turning at the same radius if the power changes. Also limits change in power to wheels, and attempts to clamp wheel power to -1.0 to 1.0 but is not always successful due to interactions with the power change limiting.
2020-01-05 Report battery level and path and motion
2020-01-07 Switch to 2020 mouse config
2020-01-07 Add wheel max power as a config param
    Turns out that running the motors overvoltage is probably not good for the motors
2020-01-07 Reorganize files and remove old stuff so there is less clutter
    Move all code to software directory
    Move all non technical things to non_technical directory
    Remove pictures since they are large binaries
    Remove drawings since they are from the first mouse
    Remove bluetooth board since it failed is no longer necessary
    Remove micromouse_maze_tool since it is large and not used that much
    [bluetooth_board-B_Cu.dxf, bluetooth_board-Edge_Cuts.dxf, bluetooth_board-F_Cu.dxf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]
2020-01-08 Add motor characterization function
    Steps through motor powers and reports encoder ticks, battery level
2020-01-10 Reset bot from UI
    [main.rs]
2020-01-11 Remove old penplot
    [output.dxf]
2020-01-19 Better upload scripts, fix warning, some tuning
    [config.rs, main.rs]
2020-01-20 Do PIDF on the wheel velocities, which are calculated from the curvature
    Gives finer control to tune each motor individually, and should be easier to tune.
2020-01-27 Do PID on encoder ticks / ms instead if mm / ms for more resolution and tune for 2019 mouse
2020-01-30 Do PID on curvature
2020-02-01 Project left and right sensors
2020-02-12 Project sensors from actual sensor positions
2020-02-14 Fix wheel slip simulation
    [lib.rs, simulation.rs]
2020-02-14 Localization basically works for a few cases with a bug or two
    [config.rs, lib.rs, map.rs, math.rs, maze.rs, simulation.rs]
2020-02-15 If the approx direction from approx sensor orientation does not help in determining which direction to use, use an approx direction based on the previous location.
2020-02-15 Put the correct delta position in the debug
    [map.rs]
2020-02-15 Only show projected walls if they are there, change uart baud.
2020-02-17 Add hardware inputs to debug
    Includes encoders and distance sensors
2020-02-17 Filter the distance readings
    Averages them over 8 samples
2020-02-18 Only update one distance sensor per loop to keep cycle times consistent
2020-02-18 Don't calc direction from sensors
    It is very noisy and makes things break.
2020-02-19 Up sim wheel accel
2020-02-21 Fix filter
2020-02-21 Use angle from path instead of from encoders
2020-02-22 Fix timer overflow from when the clock was increased
    [main.rs, time.rs]
2020-02-22 Filter the distance sensors
2020-02-24 Up the dead battery level
2020-02-24 Config for 2020 mouse
    Config for reversing motors
    Config for using sensors
    [config.rs, main.rs, map.rs, motion.rs, mouse.rs, uart.rs]
2020-02-29 Fix it up for maze use
    Only send debugs if starting or started
    React to UART bytes correctly
    Function to echo UART
    [main.rs]
2020-02-29 Add board for programmer adapter
    Also put all the baords in the electrical folder
    [board2.csv, board2.kicad_pcb, board2.sch, programmer-B_Cu.dxf, programmer-Edge_Cuts.dxf, programmer-F_Cu.dxf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]
2020-03-01 If about to hit wall, don't
    Doesn't always work
    Also fix some uturn bugs
    [comms.rs, config.rs, lib.rs, localize.rs, main.rs, maze.rs, mod.rs, motion_control.rs]
2020-03-01 Turning must be within tolerance rather than past the target
    [config.rs, motion_queue.rs, mouse.rs, turn.rs]
2020-03-01 Motion plan end position west case should offset in x direction
2020-03-01 use sensors
2020-03-02 Don't reset position when aborting
    [localize.rs, motion_queue.rs, mouse.rs]
2020-03-03 Abort if too close on left or right
    [mouse.rs]
2020-03-04 Adjust sensor thresholds
2020-03-07 Don't use left or right sensor if it changes too quickly
2020-03-08 Make sure delta^2 of last side sensors is within limits
2020-03-18 Make abort distances configurable, reset direction if move wrongly
    [config.rs, localize.rs, main.rs, motion_queue.rs, mouse.rs]
2020-04-17 Fix a failing motion planning test
    [mod.rs]
2020-04-17 Include flow png, test cache
2020-04-21 System test to allow uart control of hardware
2020-04-21 Python analyze script to analyze the motors
2020-04-22 analysis: calculate motor velocities
2020-04-22 analysis: graph motor velocity and position
2020-04-23 analysis: Allow changing gain when stepping motors
2020-04-25 analysis: Put motor analysis main code in a function and only call it if the modules is run
2020-04-25 analysis: Calculate final value for a change of only one in of the output power
    Uses the gain
2020-05-06 analysis: Add script to calculate required motor accelerations
2020-05-08 analysis: calc motor torque
2020-05-09 firmware: Option to report distance sensors in system test
2020-05-09 logic: Offset turn moves correctly when motion planning
    [config.rs]
2020-05-10 logic: localize: Only filter the distances if they are going to be used
2020-05-10 logic: change sim config turn tolerance to match real mice
    [config.rs]
2020-05-10 logic: localize: Filter distance by max range and us the last reading when the current is unknown
2020-05-10 logic: map: reset saved readings once they are all there
    [map.rs]
2020-05-10 logic: localize: Factor out common front sensor filtering
2020-05-10 logic: localize: Make sure both left and right sensors are reading to use them
2020-05-10 logic: localize: Front sensor offset from the cell that the front sensor is in
    Had issues before when the mouse and the sensor were in different cells, caused a cell jump.
    [localize.rs]
2020-05-10 logic: localize: Don't reset last raw distance in filter when not stabilized
    [localize.rs]
2020-05-10 logic: config: Adjust pid values
2020-05-11 logic: config: Reverse wheels for other board
    [config.rs]
2020-05-11 logic: localize: fix filter tests
    [localize.rs]
2020-05-15 firmware: System test prints distances with debug formatting
